ddr-yan/prototipo-inversor-trifasico/hardware/prototipo.jpg

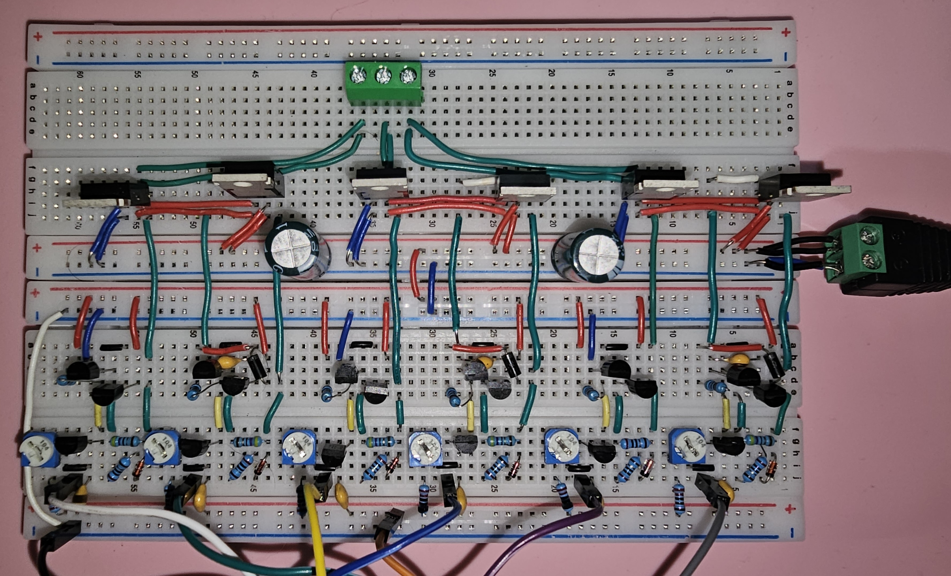
hardware/prototipo.jpg
