ddr-yan/prototipo-inversor-trifasico/hardware/medio-puente.png

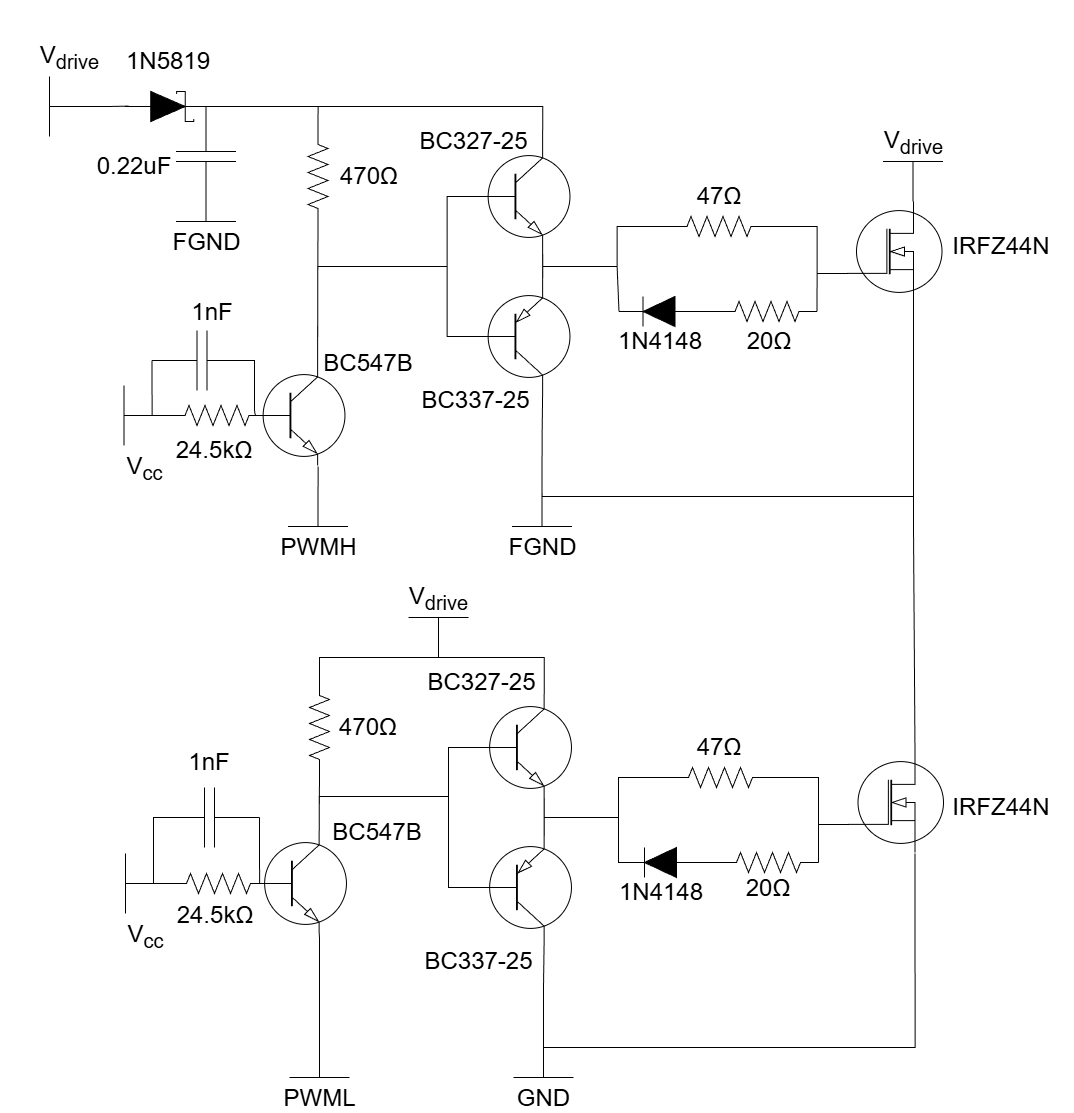
hardware/medio-puente.png
